Gernreich/swept-curve/README.md

# Trumpet, swept curve

**[← All projects](https://gernreich.github.io/)**

<!-- readme-only -->
**[Read the writeup](https://gernreich.github.io/swept-curve/)** ·
**[Turn the built spiral in 3D](https://gernreich.github.io/swept-curve/built/ribbon-spiral-bore10-45deg-R35to113/ribbon-spiral-bore10-45deg-R35to113.html)**

<!-- page-only **[Read the README](https://github.com/Gernreich/swept-curve)** · **[Turn the built spiral in 3D on a page of its own](built/ribbon-spiral-bore10-45deg-R35to113/ribbon-spiral-bore10-45deg-R35to113.html)** -->

<!-- page-only <iframe src="built/ribbon-spiral-bore10-45deg-R35to113/ribbon-spiral-bore10-45deg-R35to113-embed.html" title="The built spiral's airway, 1000 mm of 10 mm square bore winding out on a planar spiral, with the bell in its port and the mouthpiece on its tail, turning slowly until you drag it" style="width:100%;height:560px;border:0"></iframe> -->

A trumpet bore cut flat from 3 mm birch ply, swept along a curve rather than
walked through a grid of cubes. A **10 mm square** airway is drawn along a
planar curve, so two faces of the tube are flat — the two **cheeks**, each one
plate — and the other two are faceted, a wall panel standing in mortices at
every facet. Nothing about it sits on a grid and nothing in it is an elbow, so
none of these could be built in Minecraft. That is what separates them from the
grid-block trumpets in
**[trumpet-elbows-allowed](https://gernreich.github.io/trumpet-elbows-allowed/)**, the same instrument walked through cubes.

They are versions of that same trumpet, not a different instrument. The airway
is the same 10 mm square, and every design here takes the **same bell and the
same mouthpiece**, which live in trumpet-elbows-allowed:
**[the bell and the mouthpiece](https://gernreich.github.io/trumpet-elbows-allowed/ends/)**.

What a swept curve buys is a smooth turn. The section grows at every mitre, and
on a curve it grows far less than at a grid corner:

| | curve | section at a turn | why it exists |
| --- | --- | --- | --- |
| grid walk | 90° turns | +41.4% | fits a walk into a box |
| swept curve | any planar curve | +3.5% at 30°, +8.2% at 45° | constant section on a smooth curve |

The grid walk packs into a box; a swept curve lies flat and turns gently.

---

## Built

**[The spiral bore](ribbon-spiral/)** — 1000 mm in 19 facets of 45°, winding out
from R34.7 to R112.9. Both sheets cut, press-fit, a bell in its square port and a
mouthpiece on its straight tail, finished in shellac and blown; its note is not yet reported.
**[Turn it in 3D](built/ribbon-spiral-bore10-45deg-R35to113/ribbon-spiral-bore10-45deg-R35to113.html)**,
with the bell in its port and the mouthpiece on its tail.

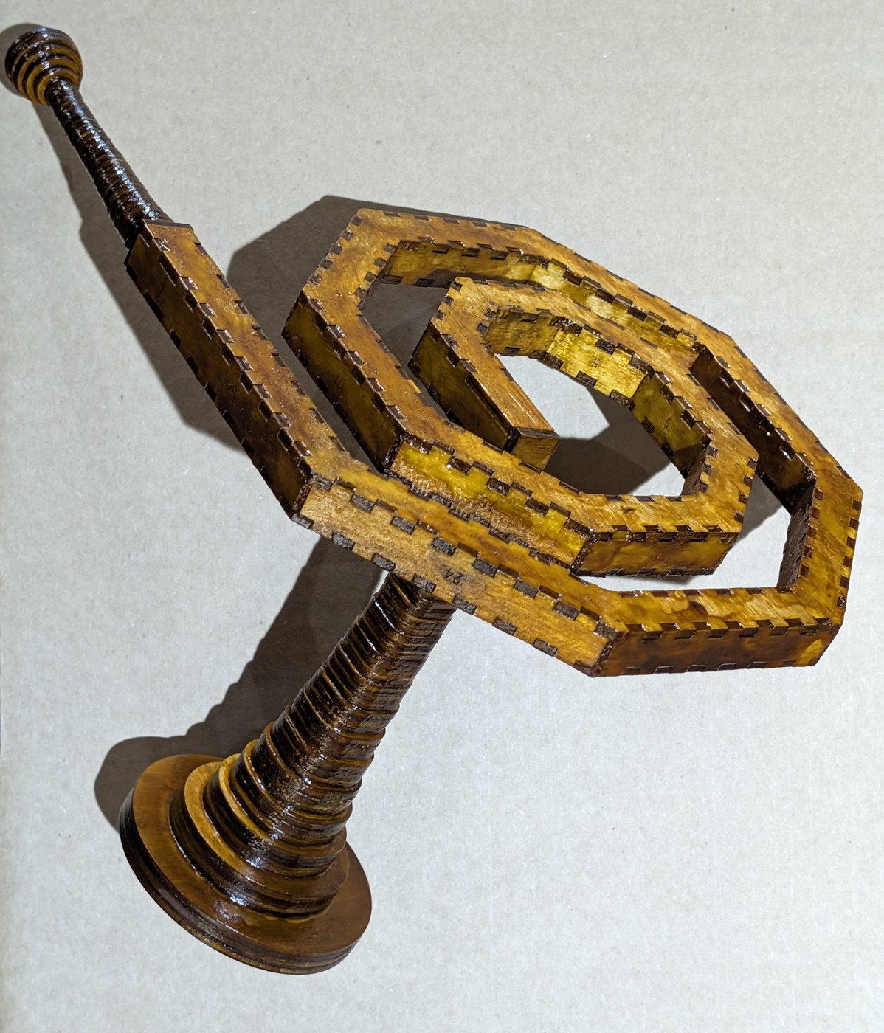
[picture p1: built/ribbon-spiral-bore10-45deg-R35to113/ribbon-spiral-bore10-45deg-R35to113-1000mm-ported-square-narrow-cheek-x2-finished_web.jpg]
The finished spiral standing upright on its bell on grey card: the bell's round rim flat on the card and its ribbed throat rising into the port at the inner end of the coil, the faceted band winding a little over two turns above it in glossy amber-brown with darker tabs along both rims, and the str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


## Designed, not yet cut

Each has its cut files and a viewer you can turn, drawn with the mouthpiece on
one end and the bell on the other, so each is a whole trumpet once those are
fitted.

| design | centreline | facets | what it is |
| --- | ---: | --- | --- |
| **[double spiral](double-spiral/ribbon-double-spiral-bore10-30deg-R62-pitch46-1506mm/ribbon-double-spiral-bore10-30deg-R62-pitch46-1506mm.html)** | 1506.4 mm | 30° | two interleaved arms winding in to meet at the centre, a straight lead leaving the rim at the top and another at the bottom |
| **[short double spiral](double-spiral/ribbon-double-spiral-bore10-30deg-R62-pitch46-1000mm/ribbon-double-spiral-bore10-30deg-R62-pitch46-1000mm.html)** | 1000.0 mm | 30° | the same with five facets off each arm, and the only design ported at both ends |
| **[double volute](volute/double-volute-bore10-45deg-R94-step60/ribbon-double-volute-bore10-45deg-R94-step60.html)** | 1179.9 mm | 45° | two interleaved arms of straight-sided semicircles winding in to meet at the eye |
| **[three-lobe serpentine](three-lobe-serpentine-with-collinear-ends/three-lobe-serpentine-with-collinear-ends-bore10-30deg-3lobes-R64/three-lobe-serpentine-with-collinear-ends-bore10-30deg-3lobes-R64.html)** | 1000.0 mm | 30° | three rounded lobes in a row, a straight lead at each end pointing opposite ways |
| **[serpentine](serpentine/ribbon-serpentine-bore10-30deg-3lobes-R72/ribbon-serpentine-bore10-30deg-3lobes-R72.html)** | 1000.0 mm | 30° | three lobes of R72 |
| **[ess](ess/ribbon-ess-bore10-45deg-5arc/ribbon-ess-bore10-45deg-5arc.html)** | 836.5 mm | 45° | a trough and a crest of R55, doubling back into a long narrow loop, level at both ends |

One more is drawn and not cut: the **[single volute](volute/single-volute/single-volute-bore10-45deg.html)**,
six semicircles of stepping radius from `volute/volute.rs`. Its inner end is
enclosed, with nowhere to go, and its two openings come out 135° apart, so it has
no cut files.

## Closed rings

A ring has no ends, so it cannot take a mouthpiece and a bell the way the
designs above do. These four are drawn because the mitring a ring needs is the
mitring every other shape needs. The ring and the scallop take two ports on named
facets, one through each cheek, which gives a mouthpiece and a bell two air paths
between them. None has been cut.

| design | centreline | facets | what it is |
| --- | ---: | --- | --- |
| **[ring](torus/ribbon-torus-bore10-27.6923deg-R128.572-800mm/ribbon-torus-bore10-27.6923deg-R128.572-800mm.html)** · **[square-ported](torus/ribbon-torus-bore10-27.6923deg-R128.572-800mm/ribbon-torus-bore10-27.6923deg-R128.572-800mm-ported-square.html)** | 800 mm | 13 of 27.7° | a 13-facet ring, ported on facets 0 and 6 |
| **[scallop](scallop/ribbon-scallop-bore10-36deg-5lobes-R44.2214-in41-800mm/ribbon-scallop-bore10-36deg-5lobes-R44.2214-in41-800mm.html)** | 800.0 mm | 36° | five lobes, ported on facets 1 and 14 |
| **[racetrack](racetrack/ribbon-racetrack-bore10-45deg-4lobes-R22-cap132.809-1600mm/ribbon-racetrack-bore10-45deg-4lobes-R22-cap132.809-1600mm.html)** | 1600.0 mm | 45° | four lobes and two caps; no port clears a neighbouring mortice, so it is unported |
| **[oval](oval/ribbon-oval-bore10-30deg-end60-R28-side-R72-flat12.2-sideflat12.5-314mm/ribbon-oval-bore10-30deg-end60-R28-side-R72-flat12.2-sideflat12.5-314mm.html)** | 314.4 mm | 30° | a small closed loop, unported |

## The double spiral

The **double spiral** is one of two shapes here whose two arms interleave — the
double volute is the other, the same skeleton drawn on semicircles. Two arms
half a turn apart about one centre, crossed in the middle by a straight:
1506.4 mm of bore on a cheek plate 232 × 241 mm. Arm B *is* arm A turned through
180°, so the gap between neighbouring passes is half the radial pitch by
construction rather than by search — choose the pitch and you have chosen the
gap. The cheek is a 20 mm band, so 46 mm a turn is the first pitch that clears it,
and the two passes come out 23.00 mm apart.

Its centreline is the one that does not step its arc radius facet by facet.
Vertices sit on a smooth spiral `r = R0 + b·θ` sampled every facet instead, which
the note beside `--shape=spiral` warns is the construction `offset()` cannot
follow. That note is about offsetting a smooth curve and faceting the result
separately; offsetting the faceted centreline is exact whatever placed its
vertices, and the airway measures 4.4e-14mm from the bore here. The stepping
construction could not be used anyway — its polar radius advances 7 mm across one
half turn and 32 mm across another, and two arms interleaved at those radii
collide.

The open middle is forced, not styled. A straight through the centre is tangent
to the crossover arc only when the arm's inner end lies outside **twice** that
arc's radius, so R62 against R30 is a floor; tighten it and the inner panels stop
being long enough to hold a 6 mm tooth, and the generator refuses rather than
drawing one. Both openings still come out on the rim facing opposite ways, which
is what a total turning of 0° buys.

Two arms wound into each other is the arrangement here that could have run
the bore back into itself, and the check that would have caught it already
existed: *the cheek outline does not cross itself*. It passes, at 85 edges and no
crossings.

The **short double spiral** is that same spiral with five facets taken off each
arm, 14 down to 9 — a trim and not a redraw: the pitch, the R62 start and the
R30 crossover are the shipped design's, and the shape stays point-symmetric
because a facet comes off each end at once. 1000.0 mm on a 186 × 236 mm cheek,
against 1506.4 mm on 232 × 241 mm.

The **facet** is what quantises it and the **lead** is what lands it. Nine
facets an arm give 956.0 mm and ten give 1058.2, so the trim alone cannot reach
1000 —
whole facets are the only thing that comes off, and they come off about 100 mm
at a time. The last 44 mm is bought by lengthening both leads from 20 mm to 42:
the lead is a straight run tangent to the arm, so it adds length without moving
a single facet of the coil. That it costs 42 mm of straight tail at each rim is
the price, and the reason the figure is quoted as a choice and not as what the
generator happened to give.

It is also the only open design in this repository **ported at both ends** —
the ported rings take their two ports on named facets, having no ends. One
square port is bought by folding the mouth lead into the facet it already lies
on, and the far end wants the same thing: `--port-both` folds the tail lead
too, or the second port lands on that lead's single tooth and the generator
refuses — the refusal being correct, and the reason the flag does the fold
rather than overruling the check. Two ports mean two open ends, so `--cap`
draws two caps. The mortices do not move: against the unmerged build, four
lead panels drop and not one surviving tooth shifts.

It ships **two port arrangements**, and the difference is which joints have been
made before. The one-port set is the spiral's: the port takes the bell, its stub
is capped, and the far rim end stays open so the mouthpiece seats on the tube
end, where four walls grip the full 16 mm. That is the arrangement standing in
ply on **[the spiral bore's page](ribbon-spiral/)**, where the photograph shows
the bell on its throat in the port and the mouthpiece out on the tail.

The two-port set below is the one where the mouthpiece must seat in a port —
10 × 10 mm through a single 3 mm cheek — which a bell has done and a mouthpiece
has not. A bell sits where it is put; a
mouthpiece takes lip pressure.

In the two-port set the ports are **split between the two cheeks**, which is
what makes it an instrument rather than a coil with holes in it. A port through
both cheeks is a socket right through, and the side you are not using is an
open hole to plug; two of those are waste. `--port-per-cheek` puts one port on
each sheet instead — `cheek-a` carries the mouth, `cheek-b` the far end, each
cut once — so the mouthpiece **enters one face and the bell leaves the other**,
at points 222.5 mm apart and exactly opposite through the coil's centre. The
openings are no longer in the plane at all, so the total-turning-zero argument
that sets the two rim ends on opposite headings has stopped describing how it
is played: those ends are the capped ones. `rotatable()` reports that the two
sheets are the same part half a turn apart, to 9e-16mm — so one sheet cut twice
with one turned round would also do, at the price of engraved numbers upside
down on the turned one.

## The generator

`ribbon_bore.rs` draws every sheet here, and `ribbon_view.rs` every viewer page;
the viewer reads its design from the generator rather than keeping a copy. Both
are Rust since 2026-11-07, built with `cargo build --release` (`Cargo.toml` and
`Cargo.lock` beside them); they were Python until then, and the move changed no
byte of any sheet or page. `CLAUDE.md` holds the rules for changing either, and
`NOTES.md` the reasoning and measurements behind them.

```sh
cargo build --release
target/release/ribbon_bore --shape=spiral --port --port-square --cap --narrow --no-write
```

That runs every check on the built spiral's design and writes nothing. Every
shipped sheet is `--narrow`; **[the spiral bore's page](ribbon-spiral/)** gives
the command that drew the sheets that were cut. `ribbon_bore.rs` is also a
library: it lends its path writer to [square-flute](https://github.com/Gernreich/square-flute),
the ocarinas, the panpipes and the chanters, and its panels and sheets to
[lyre-harp](https://github.com/Gernreich/lyre-harp), each of which expects this
repository cloned beside it.

## SolidCraft designs

Every design folder also holds the bore as a parametric SolidCraft design,
`solidcraft/NAME.sc` beside the script it was built from
(`solidcraft/NAME.solidcraft.json`), and the STEP file SolidCraft builds from it,
`step/NAME.step`, to open or import in a CAD program such as Fusion or FreeCAD: one
solid body per part, in millimetres, assembled, with no parameters. The bore lies flat
as the cut files draw it, the cheeks above and below.

The centreline's vertices are the design's parameters (`c0_x`, `c0_y` and on, under the
**SOLID** tab, **MODIFY** panel, **Change Parameters**), with these:

| Parameter | Default | What it is |
| --- | --- | --- |
| `bore` | 10 mm | the airway, wall face to wall face and cheek to cheek |
| `ply` | 3 mm | the walls and cheeks, nominal |
| `sheet` · `kerf` · `slot_tighten` | 3 · 0.15 · 0 mm | what the sheet calipers, the beam, and how much narrower the mortices are drawn: together, how far each narrow cheek runs past its walls |
| `tooth` · `shoulder` · `play` | 6 · 2 · 0.025 mm | each tooth and each gap along a panel, the least of it left past its end teeth, and each mortice's play a side along its tooth |
| `port_across` · `port_along` · `port_from_tip` | as built | a ported design's ports, as cut, and each one's middle along its facet |

Everything else is a read-only parameter worked out from these as `ribbon_bore.rs`
works it out: each wall offset (bore + ply)/2 from the centreline and mitred where its
neighbouring offset lines meet, the cheeks' rims the same way, each panel along its
wall with its ends trimmed ply/2 · tan(turn/2). So moving a vertex moves the walls,
cheeks and panels with it. The panels have their teeth and the cheeks their mortices
(2026-11-09), each panel as many teeth as its length holds; a panel whose cut
files carry another count keeps it (twelve panels, all in the four ported designs). The cheeks' rims are as cut: the generator draws
a narrow cheek's rim on its mortices' outer edges with no kerf added, so the beam
leaves it half a kerf inside the line, at a free end too, and every mortice is a notch
open to the rim. Each design has the ports its committed cheeks are cut with (the
spiral, the 1506 mm double spiral, the scallop and the torus, square-ported); none
has caps. The built spiral's lead panel is folded into the next, as its cut files fold
it.

**Checked**: before writing, `ribbon_solidcraft.rs` checks every wall point, rim point
and panel against the generator's own, and the script stops if one is off. Built by
SolidCraft, no two parts of any design overlap. The serpentine and the ring changed to
a 12 mm bore match the generator's `--bore=12` part by part, and the serpentine with a
vertex moved 4 mm still builds with no overlap. Read back with `sc-flatten
--redraw-all`, every one of the eleven designs lands on its committed cut files: cuts
within 0.021 mm, engraved marks within 0.113 mm (2026-11-09).

```sh
target/release/ribbon_view --shape=serpentine --narrow --solidcraft=FILE.solidcraft.json
solidcraft-cli run FILE.solidcraft.json --save NAME.sc     # or --out NAME.step
```

The flags are the design's own, as its viewer page is drawn, plus `--narrow`.

## Files

| | |
| --- | --- |
| `built/` | the spiral bore, which exists in wood: its cut files, previews, photographs, viewer, and the framed build of the viewer this page opens with |
| `ribbon-spiral/` | the spiral bore's page |
| `double-spiral/` · `volute/` · `three-lobe-serpentine-with-collinear-ends/` · `serpentine/` · `ess/` | the open designs, a folder each: cut files, a viewer and the SolidCraft design with its STEP file |
| `torus/` · `scallop/` · `racetrack/` · `oval/` | the closed rings, the same way |
| `previews/` | display renderings of the designs' cut files — **not** cut files |
| `ribbon_bore.rs` · `ribbon_view.rs` · `ribbon_view_page.rs` · `bin/` | the generator and the viewer (the last holds the viewer's page, browser code); `Cargo.toml` · `Cargo.lock` build them |
| `ribbon_solidcraft.rs` | each design as a parametric SolidCraft design, written by `ribbon_view --solidcraft=FILE` into the design's `solidcraft/` and built into its `step/` |
| `volute/volute.rs` · `volute/volute.json` | the compass construction behind the single volute |
| `CLAUDE.md` · `NOTES.md` | the rules, and the reasoning behind them |
| `README.md` · `index.html` | this writeup and its published page; the markdown is the source |

Until 2026-10-14 all of this was `parts/bore/concept/swept-curve/` and part of
`built/` in trumpet-elbows-allowed, and its history came with it.

## More, and licence

Built for **[LaserMadeMusic](https://www.youtube.com/@LaserMadeMusic)**, where the
cutting and the playing are shown.

**[The rest of the build files](https://gernreich.github.io/lasermademusic.html)** — every instrument,
each with its own writeup.

**[Download everything as a ZIP](https://github.com/Gernreich/swept-curve/archive/refs/heads/main.zip)**

Released under [CC0 1.0](LICENSE). Boxes.py is Florian Festi's and is
GPL-3.0-or-later; none of it is in this repository.

## Credits

Made by Michael Gernreich with [Claude](https://www.anthropic.com/claude) (Anthropic), working in Claude Code, which co-wrote the code and the documentation. Commits Claude made carry a `Co-Authored-By: Claude` line.
