Gernreich/swept-curve/built/ribbon-spiral-bore10-45deg-R35to113/ribbon-spiral-bore10-45deg-R35to113-1000mm-ported-square-narrow-cheek-x2-glued-up_web.jpg

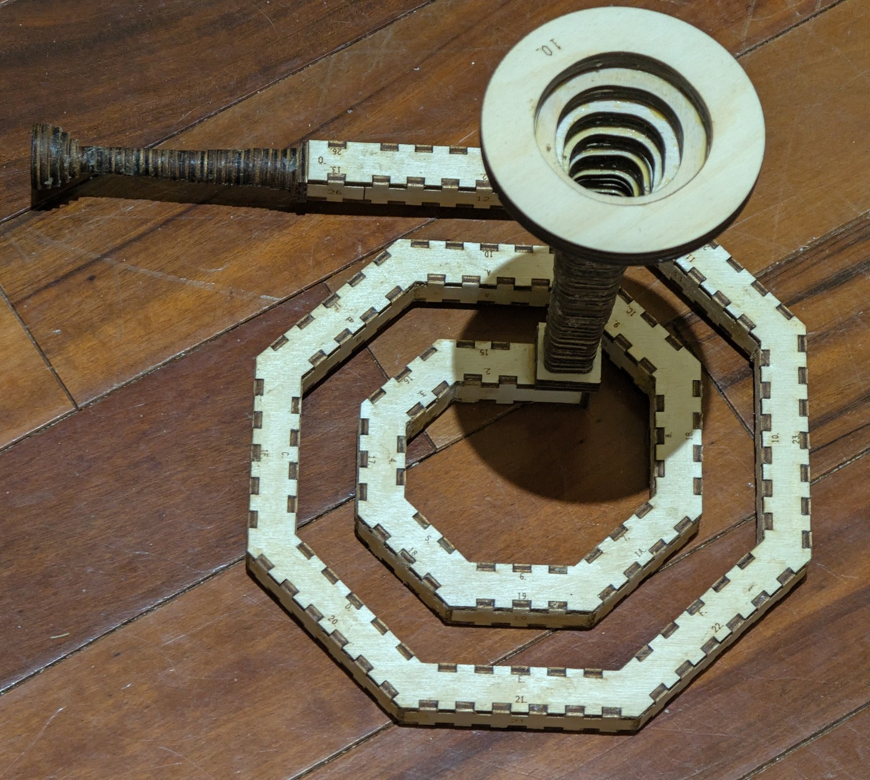
built/ribbon-spiral-bore10-45deg-R35to113/ribbon-spiral-bore10-45deg-R35to113-1000mm-ported-square-narrow-cheek-x2-glued-up_web.jpg
