Gernreich/swept-curve/built/ribbon-spiral-bore10-45deg-R35to113/step/ribbon-spiral-bore10-45deg-R35to113.step

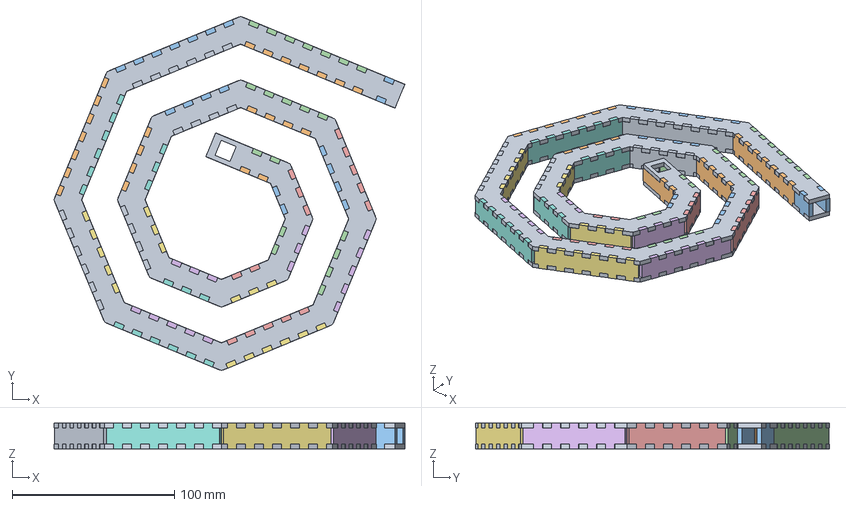
[picture p4: CAD file, 2026-11-09]
built/ribbon-spiral-bore10-45deg-R35to113/step/ribbon-spiral-bore10-45deg-R35to113.step
216.5 x 218.3 x 16.0 mm
