Gernreich/swept-curve/double-spiral/ribbon-double-spiral-bore10-30deg-R62-pitch46-1000mm/step/ribbon-double-spiral-bore10-30deg-R62-pitch46-1000mm.step

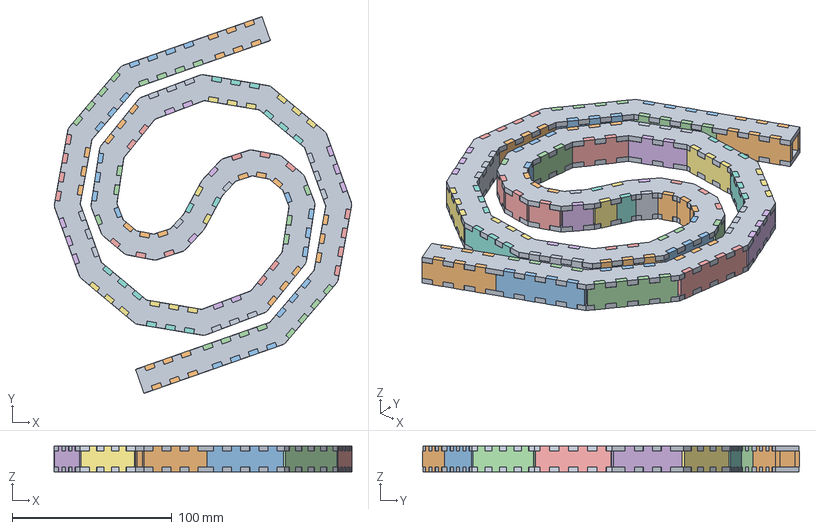
[picture p5: CAD file, 2026-11-09]
double-spiral/ribbon-double-spiral-bore10-30deg-R62-pitch46-1000mm/step/ribbon-double-spiral-bore10-30deg-R62-pitch46-1000mm.step
186.2 x 235.9 x 16.0 mm
