Gernreich/swept-curve/double-spiral/ribbon-double-spiral-bore10-30deg-R62-pitch46-1506mm/step/ribbon-double-spiral-bore10-30deg-R62-pitch46-1506mm.step

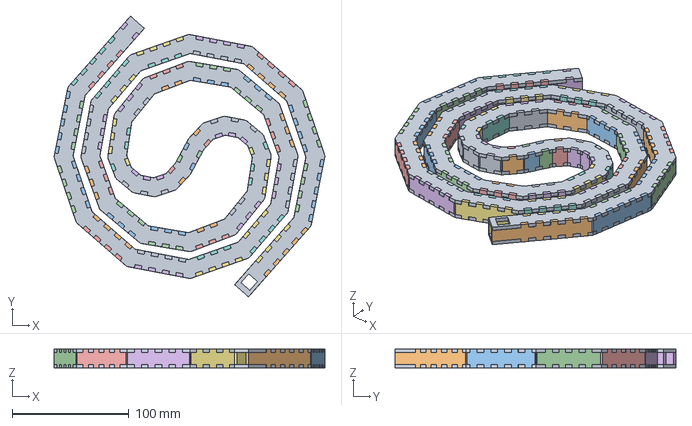
[picture p6: CAD file, 2026-11-09]
double-spiral/ribbon-double-spiral-bore10-30deg-R62-pitch46-1506mm/step/ribbon-double-spiral-bore10-30deg-R62-pitch46-1506mm.step
232.2 x 240.9 x 16.0 mm
