Gernreich/swept-curve/ess/ribbon-ess-bore10-45deg-5arc/step/ribbon-ess-bore10-45deg-5arc.step

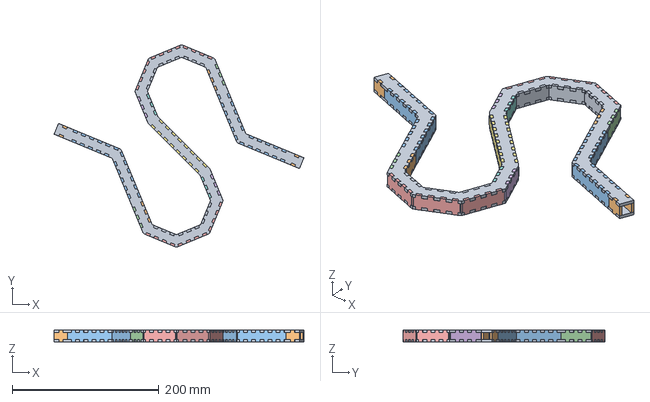
[picture p7: CAD file, 2026-11-09]
ess/ribbon-ess-bore10-45deg-5arc/step/ribbon-ess-bore10-45deg-5arc.step
340.1 x 275.5 x 16.0 mm
