Gernreich/swept-curve/oval/ribbon-oval-bore10-30deg-end60-R28-side-R72-flat12.2-sideflat12.5-314mm/step/ribbon-oval-bore10-30deg-end60-R28-side-R72-flat12.2-sideflat12.5-314mm.step

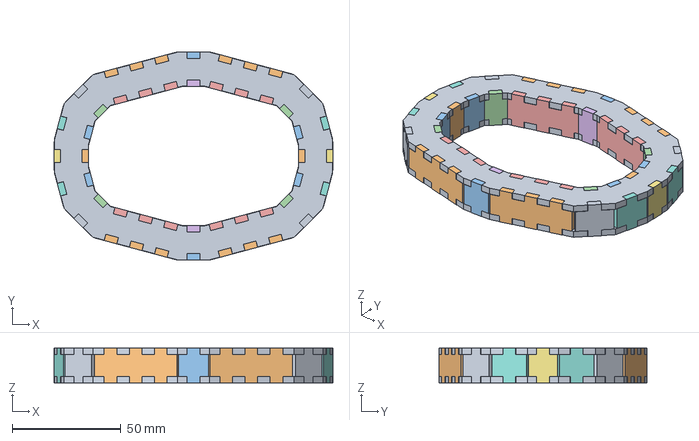
[picture p8: CAD file, 2026-11-09]
oval/ribbon-oval-bore10-30deg-end60-R28-side-R72-flat12.2-sideflat12.5-314mm/step/ribbon-oval-bore10-30deg-end60-R28-side-R72-flat12.2-sideflat12.5-314mm.step
128.5 x 96.0 x 16.0 mm
