Gernreich/swept-curve/racetrack/ribbon-racetrack-bore10-45deg-4lobes-R22-cap132.809-1600mm/step/ribbon-racetrack-bore10-45deg-4lobes-R22-cap132.809-1600mm.step

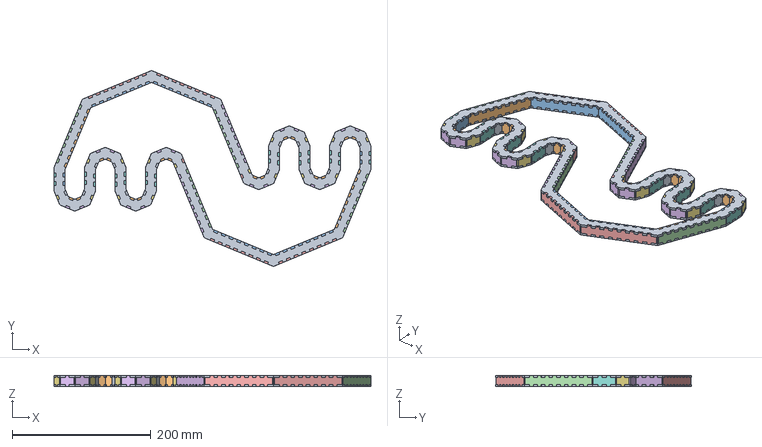
[picture p9: CAD file, 2026-11-09]
racetrack/ribbon-racetrack-bore10-45deg-4lobes-R22-cap132.809-1600mm/step/ribbon-racetrack-bore10-45deg-4lobes-R22-cap132.809-1600mm.step
457.6 x 282.6 x 16.0 mm
