Gernreich/swept-curve/scallop/ribbon-scallop-bore10-36deg-5lobes-R44.2214-in41-800mm/step/ribbon-scallop-bore10-36deg-5lobes-R44.2214-in41-800mm.step

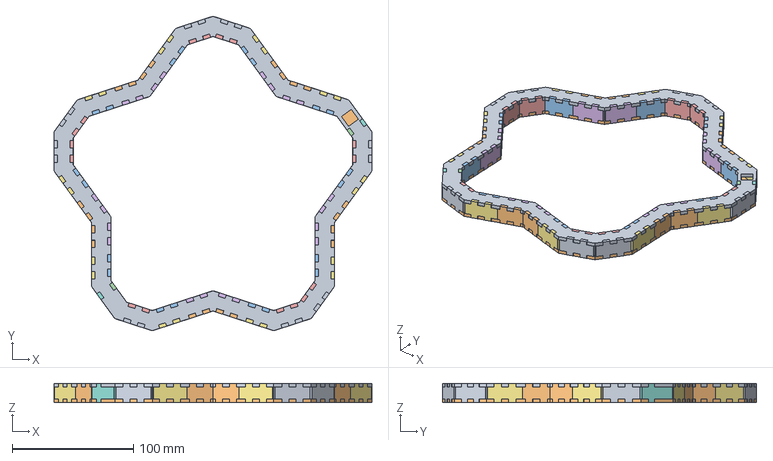
[picture p10: CAD file, 2026-11-09]
scallop/ribbon-scallop-bore10-36deg-5lobes-R44.2214-in41-800mm/step/ribbon-scallop-bore10-36deg-5lobes-R44.2214-in41-800mm.step
262.2 x 259.1 x 16.0 mm
