Gernreich/swept-curve/serpentine/ribbon-serpentine-bore10-30deg-3lobes-R72/step/ribbon-serpentine-bore10-30deg-3lobes-R72.step

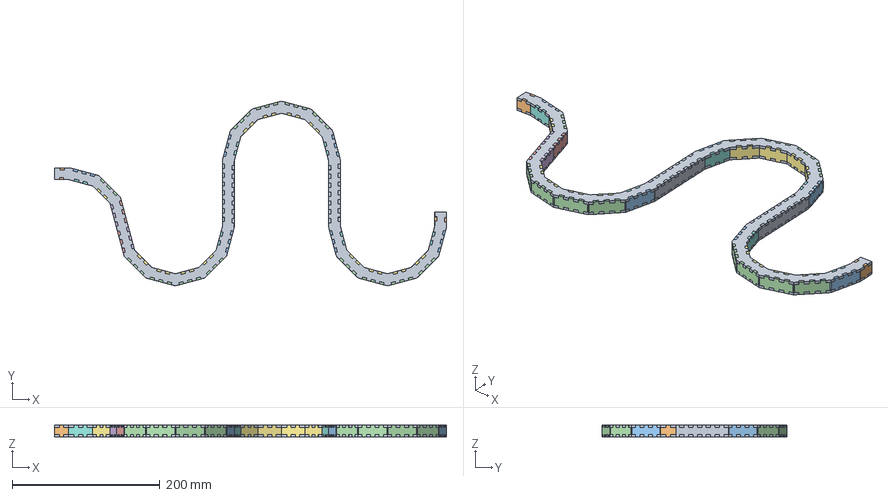
[picture p11: CAD file, 2026-11-09]
serpentine/ribbon-serpentine-bore10-30deg-3lobes-R72/step/ribbon-serpentine-bore10-30deg-3lobes-R72.step
530.3 x 249.8 x 16.0 mm
