Gernreich/swept-curve/three-lobe-serpentine-with-collinear-ends/three-lobe-serpentine-with-collinear-ends-bore10-30deg-3lobes-R64/step/three-lobe-serpentine-with-collinear-ends-bore10-30deg-3lobes-R64.step

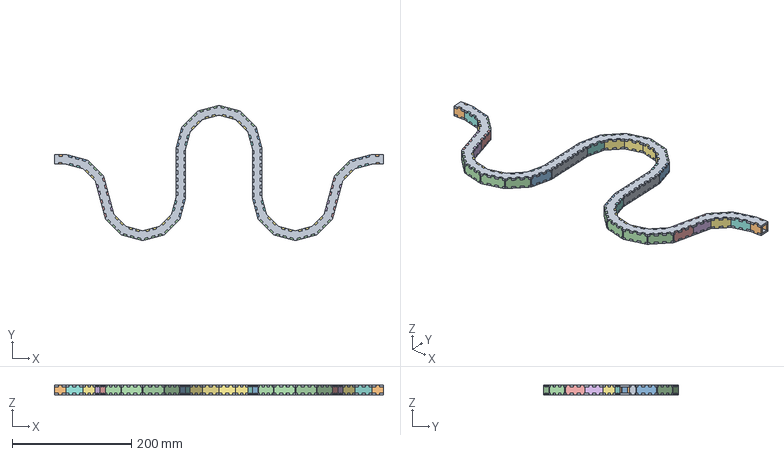
[picture p12: CAD file, 2026-11-09]
three-lobe-serpentine-with-collinear-ends/three-lobe-serpentine-with-collinear-ends-bore10-30deg-3lobes-R64/step/three-lobe-serpentine-with-collinear-ends-bore10-30deg-3lobes-R64.step
552.0 x 226.7 x 16.0 mm
