Gernreich/swept-curve/torus/ribbon-torus-bore10-27.6923deg-R128.572-800mm/step/ribbon-torus-bore10-27.6923deg-R128.572-800mm.step

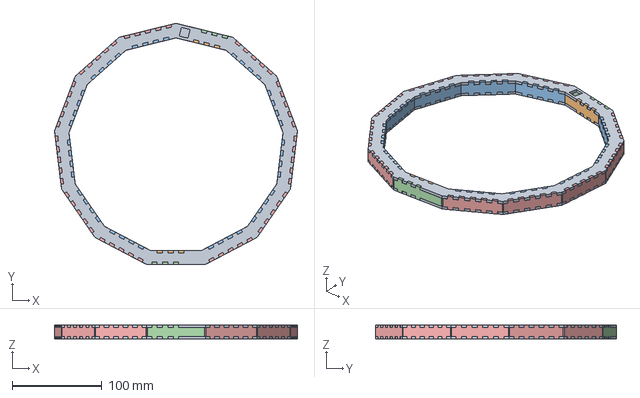
[picture p13: CAD file, 2026-11-09]
torus/ribbon-torus-bore10-27.6923deg-R128.572-800mm/step/ribbon-torus-bore10-27.6923deg-R128.572-800mm.step
271.4 x 269.5 x 16.0 mm
