Gernreich/swept-curve/volute/double-volute-bore10-45deg-R94-step60/step/double-volute-bore10-45deg-R94-step60.step

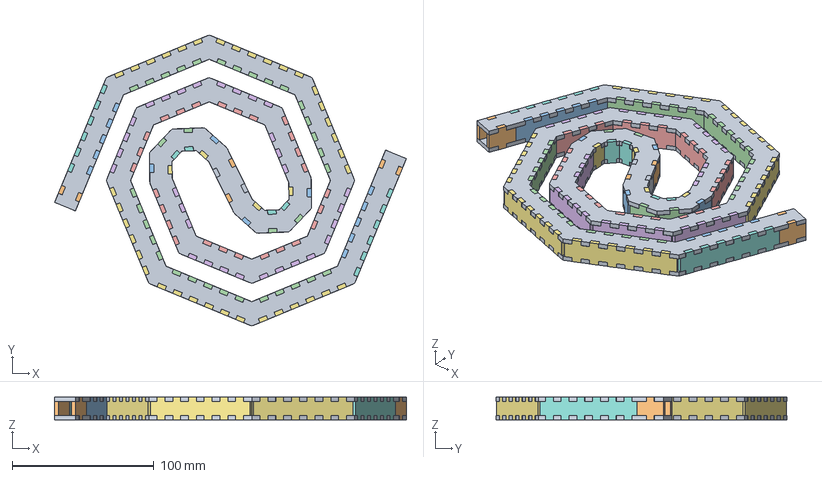
[picture p14: CAD file, 2026-11-09]
volute/double-volute-bore10-45deg-R94-step60/step/double-volute-bore10-45deg-R94-step60.step
248.1 x 205.0 x 16.0 mm
