Gernreich/swept-curve/(commit log)

2026-09-06 Restructure: a trumpet is a mouthpiece, a bore and a bell
    The top level was five siblings that did not say how they related --
    bores/, designs/, spirals/, parts/, tools/ -- with parts/ meaning only
    the two ends and the tube filed somewhere else entirely. It now says the
    thing the project has been repeating since the first writeup: a trumpet
    is a mouthpiece, a length of tube and a bell, and only the tube differs.
    parts/mouthpiece/
    parts/bell/
    parts/bore/built/ exists in plywood
    parts/bore/concept/ exists as a walk and a cut file
    walk/elbows/ a turn stranded as its own piece
    walk/no-elbows/ every turn folded into a piece
    s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
2026-09-06 Give every swept-curve bore its own directory, cut files apart
    swept-curve held one flat ribbon/ folder of 28 cut files, 10 pages and two
    generators, with the bore a file belonged to legible only from its name.
    It is now a directory per curve type, a directory per bore inside that,
    and the four cut files of each bore in a cut-files/ of their own:
    swept-curve/
    coupon/ opposed/ serpentine/ wave/
    spiral/
    ribbon-spiral-bore10-45deg-R35to113/
    ribbon-spiral-bore10-45deg-R36to144/
    ribbon-spiral-bore10-45deg-R74to144/
    cut-files/
    Seven bores, four cut files each. ribbon/ itself is gone: the generators,
    the writeup and traces/ and volute/ sit at swep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
2026-09-06 10mm is the only bore: no 25/31mm left in code or prose
    The octagonal work leaves the repository. ribbon-torus-bore25-45deg-R76.html,
    ribbon-traced-octagonal-trumpet-bore25-45deg.html and traces/octagonal-trumpet.json
    move to ~/LaserMadeMusic/octagonal, which is deliberately not a git repository.
    --shape=torus and --trace= stay: they are general, and the next closed ring or
    measured curve will want them. traces/ keeps volute.json.
    Defaults follow. bell.py and mouthpiece.py - the square pair, which ship no cut
    files - go to BORE 10.0, PLATE 16.0, RT 5.0. sizes.py holds one row.
    PLAY_BY_BORE is {10.0: 0.025} in both bore_split.py and ribbon_bore.py, and the
    clearance note stands on the 10mm b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
2026-09-06 Second 25/31mm pass: the ones that were live code, not prose
    The first pass swept what said "25mm" or "31mm". This one swept every bare 25
    and 31, which is where the arithmetic was hiding.
    Live code that was still cutting or printing at the old pitch:
    - mouthpiece.py was BROKEN, by my own previous commit. PLATE moved to 16 while
    cup[0] stayed at a 25mm aperture, so station one's hole was wider than its own
    plate and the seat check refused to write: "station 2 falls through station 1".
    The cup is now derived - BORE down to a 5mm neck over NCUP stations - so it
    cannot be left behind by a change to BORE again. Runs, 23 rings, 10 -> 3.66 ->
    10.06mm.
    - hilbert.py multiplied block coun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
2026-09-07 Generated sheets go in cut-files/; the command block runs
    Every reader in parts/ looks in cut-files/, and the generators wrote beside
    themselves. Running the command block in parts/CLAUDE.md therefore dropped 22
    loose sheets into parts/bell and parts/mouthpiece that nothing read and the next
    `git add` would have committed. Five generators now place a GENERATED name via
    in_cut_files(); a name the caller gives is still used exactly as given, wherever
    it points.
    The readers move the other way. A section, view or turn drawing is not a cut
    file -- send one to a laser and it is scrap -- so display_out() climbs back out
    of cut-files/ to the part's own directory, dropping the "-cut-files" the sourc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
2026-09-07 Lenses 9-13 across the eight CLAUDE.md files
    The cross-document lenses, which compare documents with each other and with the
    repository rather than reading one in isolation. Everything below was tested, not
    inspected.
    LENS 9 -- THE SAME FACT STATED TWICE. Four stale check counts, each contradicted
    by a live run:
    fold2 "213 checks, 0 failed on this bore" -> 195
    fold2 "194 checks still say pass" -> 195
    flat-drop "253 checks on this design" -> 251
    fold2-long-str "still passes 392 checks" -> 393 on the 3t
    tools "reports 194 checks and 0 failed" -> 195
    Three of the five are off by exactly one, which is th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
2026-09-07 Add --shape=dspiral: two spiral arms interleaved about one centre
    1506.4mm of 10 x 10mm bore on a 237 x 244mm cheek plate, 42 facets of 30
    degrees, 84 wall panels and two cheeks across two sheets. Plain and ported,
    as every other design in this folder ships.
    Arm B IS arm A turned through 180 degrees, so the gap between neighbouring
    passes is half the radial pitch by construction rather than by search. The
    cheek is a 20mm band, so 46mm a turn is the first pitch that clears it and
    the passes come out 23.00mm apart.
    Its vertices sit on a smooth Archimedean spiral sampled every facet rather
    than on stepping-radius arcs. The note beside --shape=spiral calls that the
    one construction offset() ca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
2026-09-07 Give the wave and the spirals their own facet angle
    FACET defaults to the coupon's 30 and both are 45 degree designs, so a bare
    --shape=wave built arcs that do not close and reported six check failures,
    not one of which said "facet", and a bare --shape=spiral refused because 17
    facets turn 480 degrees at 30. Neither was a wrong number; the default was
    simply the wrong shape's.
    FACET_BY_SHAPE carries the angle a shape is drawn at, applied only where the
    caller has not passed --facet -- the same guard the opposed lobe already
    uses. dspiral's own default crossover radius moves 28 -> 30 for the same
    reason: it was cut at 30, and a bare run refused on a 9.77mm inner panel.
    All six shapes now bu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
2026-09-08 A centre-first test piece off the dspiral, and a repair to get it written
    --ds-half stops at the centre instead of carrying on into the second arm, and
    runs out from there, so the mouth is the middle of the coil. The crossover is
    the part of this shape that had to be solved rather than chosen, which makes
    it the part a coupon should prove. At --ds-facets=2 that is 195.8mm in 22
    parts on a 111 x 139mm cheek, cut plain and ported.
    The repair came first because nothing could be written without it. Every
    filename literal in the generator had "ribbon/" spliced into it - "-cut-files"
    had become "-ribbon/cut-files", "mm.svg" had become "ribbon/mm.svg", "-ported"
    had become "-ribbon/ported", and th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
2026-09-09 Finish dressing the double spiral: the four previews and the half's own page
    The 1506mm dspiral shipped without previews -- 36 cut files in swept-curve and
    32 previews, and the four missing were exactly its sheets, plain and ported. It
    was the only bore in the family without them.
    The half-196mm test piece had cut-files/ and nothing else, where every other
    bore directory, the coupon included, holds the page you turn beside the sheets
    you cut.
    Building that page needed two fixes in ribbon_view.py, both the same shape as
    faults already recorded in it. --ds-half was not in its argument table, so it
    was rejected outright -- the third thing this second copy of the generator's
    CLI has lacked tha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
2026-09-09 Sweep the volute: interleave the return arm, and both its problems go
    volute.py recorded two things it could not do and said what the work was:
    "interleaving a return arm so that both ends reach the rim". This is that.
    1. The inner end was enclosed. A volute winds in and STOPS, and that end came
    within 7.75mm of the rest of the bore where it needs 20. There is now no
    inner end: the arm runs rim to eye and the return arm carries it back out.
    2. The ends were not opposed. 24 facets at 45 degrees turn 1035 degrees, and
    opposed needs (F-1) a whole number of turns, i.e. F = 8k+1, which no whole
    number of semicircles gives. It cost nothing in the end. The arm's centres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
2026-09-09 Say which curve each shape's vertices sit on: the double spiral is Archimedean, the volute is a chain of semicircles
    The distinction existed only in one source comment. It appeared in no printed
    report, no page, and no writeup -- "Archimedean" occurred exactly once in the
    whole tree, beside DS_PITCH, and a reader of the drawings had nothing to go on.
    The two shapes look alike and are not.
    dspiral vertices sampled every facet off a smooth Archimedean spiral,
    r = R0 + b*theta, so the radius differs at every vertex
    volute a chain of semicircles of stepping radius about two alternating
    centres, the radius holding all the way across each arc
    It shows in the loca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
2026-09-09 Trim the wall panels so their corners stop jamming at every mitre
    Reported from the bench: the dspiral halftest was cut, and where the walls meet
    at less than 180 degrees the panel corners butted before anything could seat.
    It is real, it is in every ribbon bore shipped, and it is arithmetic.
    A panel end is a SQUARE cut -- a laser goes through the sheet and cannot mitre
    one -- and the offset polyline is the wall's CENTRELINE, so two neighbours have
    THICK/2 of ply either side of the point where their centrelines meet. On the
    concave side each runs past that point by (THICK/2)tan(phi/2), and the two
    corners collide. The overlap is THICK*tan(phi/2):
    30 degree facets, 3mm ply 0.804mm a j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
2026-09-09 Audit every check against geometry it should reject; three could not fail
    The halftest was cut with eleven checks passing and its corners jammed, so each
    check was given something it ought to fail. Seven do. Three cannot, and one of
    those was the headline.
    CANNOT FAIL
    the airway is the bore along every facet
    compares two offsets of ONE polyline, which are parallel to each facet at
    a fixed separation by construction. It returns 10mm for a straight line,
    for a hairpin tighter than its own wall, and for a zigzag reversing at
    every vertex. Kept -- it is the arithmetic of the section and would catch
    a mistake in offset() -- but it is not evidence.
    the shortest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
2026-09-09 Audit volute.py and ribbon_view.py; catch the generator's refusal in the viewer
    The last two check surfaces in this directory.
    volute.py. Two of its four checks are failing on the shipped design right now --
    the bore stays clear of itself at 7.75mm against the 20mm band, and the two
    openings are opposed at 135 degrees. That is the file's whole point, and it
    makes them the best-evidenced checks in the repository: no mutation needed. the
    cheek fits the P2S bed fires from --r0=200 up. Both its refusals hold, an arc
    under the tooth floor and a facet that does not divide a semicircle. The two
    failing checks are one condition stated twice and they agree: the run turns 1035
    degrees, 315 past whole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
2026-09-09 Take 0.1mm off the slots in both directions: the halftest assembled loose
    Reported from the bench after putting the dspiral halftest together. Taken off
    the SLOT and not added to the tab, which is this file's standing rule -- TOOTH
    feeds the shoulder arithmetic and the panel-length guard, so widening the tab
    moves numbers that are checked, while the notch is free.
    It has to come off the slot across the ply whatever the rule said, because in
    that direction the tab is not drawn at all: its thickness IS the sheet, and
    nothing in an SVG can add to it.
    slot drawn slot cut fit
    along the tooth 5.950 -> 5.850 6.050 -> 5.950 +0.050 -> -0.050mm
    across the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
2026-09-09 The ply is 2.94mm and the kerf 0.13mm: put the measured numbers in
    Calipered at the bench. Both constants were assumptions, and both were wrong in
    the direction that makes a joint loose -- parts come out smaller than drawn and
    holes bigger, and the sheet was 0.06mm thinner than the slot cut for it.
    along the tooth across the ply
    as you cut it +0.110mm +0.090mm
    now +0.050mm +0.000mm
    The first row is the joint that was loose: twice the slack this file asks for in
    one direction and, in the other, 0.09mm of slack where it specifies none. The
    second row is what it always meant to cut. So yesterday's 0.1mm slot tig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
2026-09-09 The sheet and the kerf are variables now, and the block bores get the real ones
    Answering the question directly: no, the ply thickness was NOT a variable. It
    was a module constant in two files, reachable only by editing them, and so was
    the kerf. Both are flags now, --sheet= and --burn=, on both generators.
    bore_split.py gets the same two-number split ribbon_bore.py got. THICKNESS stays
    3.0 and is a DRAWN dimension -- the airway is BLOCK - 2*THICKNESS, so putting
    2.94 there would make this a 10.12mm bore and rename every cut file from bore10-
    to bore10.12-. SHEET is 2.94 and goes where the material belongs: Boxes.py is
    handed it as --thickness, because Boxes cuts the finger slots and a slot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
2026-09-09 Boxes.py's --burn is the RADIUS: my 0.13 told it the kerf was 0.26
    Caught on a second pass, and it was mine, made this morning. Boxes.py sets its
    line width to 2*burn and offsets each side of a line by burn, so burn is half
    the kerf. Measured rather than read: raising --burn by 0.17 widened every drawn
    outline by 0.34.
    bore_split spends its own BURN as 2*BURN everywhere -- in the span arithmetic
    and the bed arithmetic -- which only balances on the same radius convention. So
    its old 0.1 always meant a 0.2mm kerf, and setting it to the measured 0.13 this
    morning told Boxes 0.26mm and compensated every part by twice what the laser
    removes.
    KERF = 0.13 measured, the full width of the cut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
2026-09-10 The port breaks into its neighbouring slot on every ported cheek
    Eighth pass, running flat-part-check over the ribbon sheets now that it can
    read them -- a gate that had never been applied to these files. It reported
    0.03mm of material where it wants 3mm, on the ported cheeks and only those.
    Measured directly rather than trusted: the port is 0.029mm from slot 0 on all
    TEN ported cheeks in the project. The kerf is 0.13mm and takes half from each
    edge, so the two holes are one hole. Every ported cheek that has been drawn
    here is uncuttable, and has been since the port was added.
    TWO FAULTS, ONE FIXED.
    port_hole() drew the hole OVER size. Its own comment said "the hole is a hole:
    kerf goes u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
2026-09-10 The longer lead does clear the port, and this file already said it cannot
    I offered lengthening the lead as the way to keep a bore-wide port, and it was
    the wrong option to offer: the label-sliding code in this same file has said so
    since before I touched it --
    "the alternative, giving the port a bore of extra lead, moves the whole coil
    and was what made the cheek cross itself"
    -- and I had not read that far before putting the choice up. Built anyway, and
    it reproduces exactly that. PORT_LEAD = 30 clears the port beautifully on the
    coupon, 0.030mm of ply becoming 2.931mm and every check passing, and then:
    spiral the cheek outline starts crossing itself
    volute 39 slot corners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
2026-09-10 A check count moved and a document did not; and my own audit was too kind
    Ninth pass, on the lens pass 8 proved out: not re-reading the scripts, but
    pointing tools at artefacts they have never seen, and reading what the files
    already record.
    THE BLOCK SHEETS THROUGH THE FLAT GATE, never done before. Boxes' own output
    comes back 8 of 9, failing only "holes are inside the outline", which is the
    multi-part sheet mismatch already known from the rosettes -- the five "holes"
    are the other five parts. No defect there, and worth knowing: that check does
    not apply to any sheet carrying more than one part, which is about half of
    what this repository ships.
    A COUNT THAT MOVED. fold2's CLAUDE.md said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
2026-09-10 The port is a 7 x 14mm slot: same open area, and it clears
    Chosen because the clearance a port must keep is measured ACROSS the run and
    nothing else -- the tab slots line both walls the whole length, so a bore-square
    10 x 10 passes within 0.16mm of one wherever it is put. Length ALONG the run
    costs no clearance at all, so it is free, and it buys back what narrowing takes:
    across along clearance opening
    10 10 0.16mm 100mm2 uncuttable, and shipped for weeks
    7 7 1.66mm 49mm2
    7 14 1.66mm 98mm2 this
    6.6 20 1.86mm 132mm2
    98mm2 against the bore's own 100, so the air sees no restriction worth the n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
2026-09-10 The flat gate agrees the port is fixed, and wants one flag to say so
    Tenth pass, checking yesterday's port fix with the tool that found the fault
    rather than with the one that missed it.
    flat-part-check now reads 1.66mm where it read 0.03mm. That is the fix
    confirmed by something that does not share a line of code with it.
    It still FAILS, and should not, because the two gates disagree about the floor:
    ribbon_bore.py MIN_FEATURE 1.5mm
    check.py MIN_FEATURE 1.5mm
    flat-part-check edge distance 3.0mm
    The 3.0 is deliberate and right for what that tool was written for -- a
    bullroarer's cord hole, under string tension, which tears out. A cheek slot is
    not under tension. The flag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
2026-09-10 port_hole()'s docstring described geometry it no longer draws
    Thirteenth pass, on a lens the earlier ones did not use: which claims did my own
    changes falsify, in the files that make them?
    The port became a 7 x 14mm slot yesterday and three descriptions of it did not:
    PORT = False "a bore-square opening through the cheek"
    port_hole() "A square opening through the cheek at the mouth"
    "This cuts a bore-square hole in the last BORE of the run"
    The function's own docstring is the one that matters -- a reader who trusts it
    believes the port is 10 x 10 and cannot be told otherwise by the code, which now
    reads PORT_ACROSS and PORT_ALONG. All three corrected, and they no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
2026-09-10 The ribbon/ splice was still in this folder's documentation, all session
    Fifteenth pass. The first task of this session repaired eleven of these in
    ribbon_bore.py and ribbon_view.py, ran a detector over 476 text files, got
    "0 places where a directory name is glued to the token before it", and called
    the class clean. Nine of them were sitting in the CLAUDE.md beside those
    generators the whole time.
    A ribbon/Boxes.py tooth is -> A Boxes.py tooth is
    ...-ribbon/cheek-x2-cut-files.svg -> ...-cheek-x2-cut-files.svg
    ...-ribbon/panels-cut-files.svg -> ...-panels-cut-files.svg
    `ribbon/lasermade-tools/make-preview.py` -> `lasermade-tools/...`
    python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
2026-09-10 Three checks that would have passed over nothing
    checks() opens by saying that a check which measured nothing would print the
    same clean run as one that measured everything, so each reports its count.
    Three of them then compared a failure count to zero with nothing asserting
    there had been anything to count: the two slot checks and the wall-panel one.
    The kerf check was the visible one. With no pair to measure, `worst` stayed at
    infinity and the note passed reading "narrowest infmm drawn, infmm left after a
    0.13mm kerf" -- a sentence that cannot be true of any drawing.
    All fourteen shape-and-port runs still report 12 of 12.
    Claude-Sess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
2026-09-10 Three places that answered without saying they had not looked
    svgpath.py STEPPED SILENTLY PAST WHAT IT COULD NOT READ. The fall-through was
    `i += 1`, so a relative lineto, an arc, or a number the pattern did not match
    was skipped and the function returned a SHORTER point list than the path
    actually visits. Every measurement downstream is taken from that list -- the
    sliver check, the bed check, the overlap check, the label placement -- and a
    quietly truncated outline is the one input none of them survives and none of
    them reports. It also matched `-?\d+\.?\d*`, so `.5` was not a number to it,
    and it tokenised only the commands it handled, so any other command's
    coordinates arrived as bare num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
2026-09-11 The viewer's default put the page one directory above where it belongs
    Every one of the seven ordinary shapes ships its page in <shape>/<stem>/, beside
    the sheets it describes. The default output was the root of swept-curve, which is
    where the traced and torus pages live and where no ordinary shape's page has ever
    been -- so a bare run dropped an unshipped duplicate at the root, one directory
    up from the real page and beside the one root page that is real. Found by running
    the file with no arguments, which is the only way anyone would meet it.
    It writes into the design directory now, and refuses when there is none rather
    than inventing one: ribbon_bore.py makes that directory when it writes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
2026-09-13 Five cheek and port options that existed only as Inkscape edits
    Each of these was done by hand on a shipped sheet, and each is now a flag, so
    the sheet can be redrawn when the kerf or the sheet thickness moves. Nothing
    about the default changes: all 30 shipped sheets still redraw identically and
    repro.py is unmoved at 64.
    --narrow puts the cheek's edge ON the mortice's outboard edge, so there is no
    web and the band is only as wide as the duct: 20mm becomes 15.81. It is NOT
    --web=0, which stops at the wall's true face and leaves an 0.095mm rib no laser
    can cut. It reads the same slot_half() the mortice does, so it tracks --kerf
    and --sheet instead of restating a number they set. It costs the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
2026-09-13 The ply is 3mm now, so every curve is redrawn narrow and the old sheets move aside
    SHEET goes 2.94 -> 3.0 on the author's instruction, for stock that measures it.
    SHEET is the MATERIAL and belongs only in the depth of the hole it passes
    through, so this deepens every mortice by 0.06 and changes nothing else. THICK
    stays 3.0 and still carries every drawn dimension.
    It also makes every sheet cut before today stale -- a 3.0mm tab will not enter a
    slot cut for 2.94 -- so all 40 of them move to an old/ beside the sheets that
    replace them, and 42 new ones are drawn at 3mm ply and a 0.15mm kerf: every
    design under swept-curve, narrow, with a square port wherever the shape takes
    one. Seven do. The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
2026-09-13 The same 3mm ply and 0.15 kerf everywhere else, and the page route that never worked
    bore_split.py gets SHEET 2.94 -> 3.0 and KERF 0.13 -> 0.15, the two numbers
    ribbon_bore.py took on 2026-09-13. It was the only other generator with either:
    the bell and the mouthpiece are already 3mm ply and carry no kerf compensation
    at all, deliberately, because their rings are glued laminations.
    THICKNESS stays 3.0 and still dimensions the lattice. SHEET reaches only the slot
    Boxes cuts for a sheet to pass through, so this moves no airway and shortens the
    three wall runs that carry a thickness by 0.06mm each. KERF here is the FULL
    width and BURN is the radius Boxes wants; the paragraph above the constant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
2026-09-13 Forty previews rendered sheets that had been superseded, and the adapter was claimed by nothing
    Three things this tree asserted about itself were no longer true after the
    narrow regeneration, and all-gates.sh found each of them.
    previews/ held forty renderings of the full-width sheets and none of the
    forty-two narrow ones that replaced them -- so every picture in the folder
    showed a sheet nobody is cutting, and the gate read "40 of 43 stale". The
    forty move to previews/old/, mirroring each design's cut-files/old/, for the
    reason the sheets themselves were kept: a preview is the only readable picture
    of what a superseded sheet cut. Out of previews/ rather than deleted, because
    the gate walks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
2026-09-13 Every old/ leaves the repository and stays on the disk
    The twenty-one cut-files/old/ folders, and the previews/old/ that mirrors them,
    hold sheets a later regeneration replaced: a different ply, a different kerf, a
    full-width cheek where the design is now narrow. They were set aside rather
    than deleted so that what a particular run drew stays recoverable. They are a
    local archive, not part of what this repository ships, and they now say so --
    "old/" in .gitignore, and 169 files out of the index.
    The files are untouched on disk. git rm --cached removed them from tracking
    only, and history up to this commit still carries every one of them.
    Three passages had to change, because each asserted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
2026-09-13 Five claims the docs made that measurement no longer supported
    A thirteen-lens review of the ten markdown documents. The mechanical half was
    clean -- 10 of 10 documents, 363 SVGs, no stroke conflicts -- so everything
    below came from the judgment lenses.
    **The bed paragraph in greek-key was stale in four numbers and wrong in one
    claim.** Every figure recomputed from the sheets' declared sizes: 592.0 x
    284.4mm and 1684cm2, not 592.4 x 284.6 and 1686; telescope-wide is 598.9 not
    599.2, hilbert/open 598.6 not 598.8, margins 1.1 and 1.4 rather than 0.8 and
    1.2. "Half again the next one" was 1.5x when written and is 1.134x now, because
    the narrow serpentine cheek is 1485cm2.
    The substantive part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
2026-09-14 ribbon_view: drop the ply cheek plates, draw the airway alone
    The two slabs at full band width, 3mm proud of the passage top and
    bottom, meant every look at the inside was a look through plywood --
    which is the one thing this page exists not to do. Faces 6 and 7,
    'ply, top' and 'ply, bottom', are gone; six faces now, not eight.
    What they were there for -- 20mm of band around a 10mm passage -- the
    numbers panel says in words and the cut files show to scale.
    All eleven pages redrawn. The airway geometry is byte-identical to
    what shipped: only the ply vertices and quads are dropped.
    --trace was missing from the `known` flag set, so the guard that
    refuses an unknown flag refused the one flag w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
2026-09-14 The first swept curve off the laser is a spiral's pair of cheeks
    Author-supplied photograph of the 1000mm spiral's cheek sheet as cut, filed
    beside the cut-files/ folder that drew it, and named for the sheet it is:
    ported-square, narrow, cheek-x2. Two copies are in the picture because that
    sheet says CUT THIS SHEET TWICE -- the two cheeks are the same part and both go
    on the same way up -- and the second is visible under the first at the straight
    tail. Same original-plus-_web pair as the bell and the mouthpiece, 3000px and
    1400px, 1.9MB for the two.
    Which sheet it is was not taken on trust. The photograph was matched against
    every cut file in that folder rendered in a browser: the square po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
2026-09-14 Boxes.py draws every finger joint here and was nowhere credited
    Seven documents name Boxes.py or SnakeBox and not one of them said whose it is,
    where it comes from or what it is licensed under. The only place in the
    repository carrying a source for it was a comment in .doc-audit-ignore, which is
    config and not a document, and the URL there -- festi.info/boxes.py -- is not one
    the project itself gives.
    The facts come off the installed checkout rather than from memory: pyproject.toml
    in ~/Software/boxes gives boxes 1.2, maintainer Florian Festi
    <florian@festi.info>, Repository https://github.com/florianfesti/boxes, license
    GPL-3.0-or-later. That URL is what every credit below names, and doc-a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
2026-09-14 The spiral is glued up, and a glue-up this size is not airtight
    Both sheets are cut and the bore is assembled, with a mouthpiece on the
    straight tail and a bell on the port. The photograph shows what the cut
    files cannot: air gaps all along both rims, at every mitre and every tab.
    They are closed with shellac, which is why the three-turn coil at the top
    of the page is the colour it is and this spiral is still bare ply.
    Claude-Session: https://claude.ai/code/session_01XTXnWTXE6TaLYt3VGZwCm7
2026-09-14 The glued-up photograph is named for the sheets it is a photograph of
    It was filed as -1000mm-glued-up, dropping the -ported-square-narrow-cheek-x2
    that its as-cut sibling carries, so the pair no longer sorted or read as one
    design photographed twice.
    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
2026-09-14 The glued-up photograph is cropped to the instrument, and the spiral is in the index
    Two thirds of the frame was floor, so the coil rendered small in a column
    sized for it. Recropped from the original to 6830 x 6128 and rebuilt at the
    repository's two sizes.
    The spiral had no row in "A page for each" despite being the second design
    here that has been cut. It gets one, pointing at its viewer, and the
    paragraph above the table says why that row is unlike the four over it.
    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
2026-09-14 The spiral bore is a page, not four paragraphs inside somebody else's section
    It is the second design here that exists in wood, and it was being described
    between the swept-curve overview and the double spiral, where it could carry
    two photographs and no numbers. ribbon-spiral/ is its own page in the shape
    the other five have: what the cheek is, what the glue-up is not, a numbers
    table off the generator's own report, and the three shipped variants set
    against each other.
    The panel count in the moved prose said 38. The photographed sheet is the
    square-ported one, and --port-square folds each wall's 20mm lead panel into
    the facet it already lies on to clear room for the port, so it is 36. Bot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
2026-09-14 A duct has two ends, and only one of them could take a port
    port_hole() drew at cline[0] and nowhere else, so "a square port on the far
    end" was not a flag that was missing -- it was a shape the generator could not
    express. --port-both adds it, and the work was not the hole.
    A square port is bought by folding the mouth lead into the facet it is already
    collinear with, because the lead's one tooth sits exactly where the port wants
    to be. The far end needs the same purchase and merge_lead() only ever folded
    ps[0]. Without the tail fold the second port lands on the tail lead's only
    tooth and teeth_kept() refuses, naming the panel -- which is the right answer
    to the wrong question. So the flag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
2026-09-14 The trim gets to 956mm and the lead lands it on 1000
    The double spiral shortens by whole facets and nothing else, so it cannot reach
    a round number: nine facets an arm give 956.0mm and ten give 1058.2, about
    100mm a step. The last 44mm comes off the leads instead, 20mm to 42 at each
    end. A lead is a straight run tangent to the arm -- centreline() makes it by
    extending the end segment's own direction -- so it buys length without moving a
    facet of the coil, and the cost is 42mm of straight tail at each rim rather
    than a redrawn spiral. 1000.0mm exactly.
    THE 956mm SHEETS ARE REPLACED, NOT KEPT BESIDE IT. They were never cut, they
    lived for one commit, and two double spirals differing by 44mm w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
2026-09-15 The mouthpiece enters one face and the bell leaves the other
    A port through both cheeks is a socket right through, because the cheek is one
    part cut twice -- and the side you are not using is an open hole to plug. Two
    ports make four of those and two are waste. --port-per-cheek splits them
    instead: cheek-a carries the mouth port, cheek-b the far one, each sheet cut
    once. No geometry moves. Same coil, same sixty panels, the same two holes in
    the same two places; only which sheet each hole is drawn on.
    THE CONSEQUENCE IS THE INSTRUMENT, and it is worth saying plainly. The two
    openings are no longer in the plane of the coil: you blow into one face and the
    sound leaves the other, at points 222.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
2026-09-15 The coupon and the coiled trumpet are deleted
    TWO COUPONS, and both go. The swept curve's was --shape=coupon, the 180 degree
    R30 test piece: its folder, four sheets, four previews, its page, the shape in
    ribbon_bore.py and ribbon_view.py, and its two rows in the reproduce gate.
    tools/coupon-16mm/ was the other, four sheets that would have settled whether
    the play requirement is absolute or a fraction of the tab.
    THE COUPON WAS NOT AN IF, IT WAS THE FALL-THROUGH. centreline() ended with the
    180 degree arc and no test on the shape, so anything reaching the bottom of the
    chain was drawn as a coupon -- a misspelt --shape produced a test piece rather
    than a complaint. That end is now a refusal n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
2026-09-15 Ten of the twelve design pages were a viewer revision behind
    Regenerated, all twelve. When ribbon_view.py learned about ports I rebuilt the
    two pages I had touched and left the rest, and nothing in the repository could
    say so: the only page under a gate is the embed in the other repository.
    TWO WERE NOT MERELY BEHIND. The 1506mm double spiral's page opened its vertex
    list at [37.979, 115.117] where the generator draws [40.856, -111.865], and the
    halftest's was wrong the same way -- geometry that matches no flags its folder
    name claims. A page that draws a bore nobody drew is precisely what this file
    exists to prevent; it was doing the opposite, quietly, on the design this repo
    is named for.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
2026-09-15 An instrument is a bore and its two ends, so built/ is not inside parts/bore
    `parts/bore/built/` filed the three-turn coil as a kind of bore. It is not: it
    is the only thing in this repository somebody can pick up and blow, and what
    makes it that is the bell and the mouthpiece on it, neither of which is a bore
    and neither of which lived in that folder. The name promised an instrument and
    the path delivered a tube.
    built/coil-fold2-long-straight-3t/ the three-turn trumpet
    built/ribbon-spiral-bore10-45deg-R35to113/ the spiral
    THE SPIRAL CAME WITH IT, which is the point of the move rather than a side
    effect. It has been cut, glued up and fitted with both ends since 2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
2026-09-15 Two gates already expected these five files, and a fresh clone had none of them
    The 1000mm double spiral's single-port arrangement -- two cut sheets, its viewer
    page and the two previews -- was written to the working disk and never added.
    Nothing said so, because everything that reads them reads the disk.
    BOTH GATES NAME THESE FILES BY PATH. all-gates.sh has
    rr $DS-1000mm/cut-files ... -ported-square-narrow ...
    vp $DS-1000mm/ribbon-...-1000mm-ported-square.html ...
    so the sheets are 2 of the 48 and the page is 1 of the 13. On this disk they
    passed; on a fresh clone they were missing files, and the gate that exists to
    catch exactly that could not see its own blind spot.
    Verified c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
2026-09-15 A port seats a bell in 3mm of ply, and nothing has seated a mouthpiece in one
    The port cuts through ONE cheek, so whatever goes into it meets 3mm of birch
    rather than the whole 16mm sandwich, and that is the first thing anyone asks
    about the joint. The section answers it with the two photographs: the R35to113
    spiral's bell stands in its square port, carried by a 10 x 10mm hole in one
    cheek, and it holds.
    WHAT IT DOES NOT SETTLE IS THE MOUTHPIECE. On both built instruments the
    mouthpiece is out on the lead, seated in the tube end where four walls grip the
    full depth. A bell sits where it is put; a mouthpiece takes lip pressure and
    whatever the player leans into it, and the 3mm has never seen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
2026-09-15 Two bores are in wood, and one of them plays; also the spiral has 19 facets
    Two corrections, both of them a document contradicting another document in this
    repository rather than anything on disk.
    THE ONE THAT EXISTS -> THE ONE THAT PLAYS. built/CLAUDE.md opens "One folder per
    instrument that has been cut, glued and assembled", and there are two folders in
    it. README.md says "the two instruments that exist in wood". Meanwhile
    three-turn/README.md opened "**The one that exists.** Every other bore here is a
    drawing", which the spiral -- cut, glued up, a bell in its port, photographed on
    its own page -- has not been true of since it was cut. The distinction the prose
    actually wants is narrower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
2026-09-16 Every torus jammed at its seam, and a ring has no end to put a port on
    turn_at() answered 0 at the first and last vertex -- "a free end turns
    through 0", which is right for a run and wrong for a ring, whose first
    and last vertex are one vertex that turns like any other. So the two
    panels either side of the seam kept the THICK/2*tan(phi/2) the trim
    exists to take off, and "no two wall panels share plan area" failed with
    exactly 2 jamming pairs, one per wall, on EVERY torus at every facet
    count and every radius. 0.37mm a panel at 13 facets, 0.62mm at 8 -- the
    1.24mm the trim's own comment quotes from the bench. It now wraps, as
    offset() already did at the seam mitre and for the same reason. No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
2026-09-16 The floor for a ported ring is the PORT, and it is R36 not R120
    The ceiling was written down and the floor was not, so a reader reaching
    for --port-at on a default ring got a refusal and no hint which dial
    moved it. It is arithmetic: a port needs PORT_FROM_TIP + PORT_ALONG/2 =
    17mm of the facet it is measured along, a ring's facet is 2*R*sin(pi/n),
    so R >= 17/(2 sin(pi/n)). R32.84 at n=12 and R35.52 at n=13 -- measured
    both ways, R32.8 and R35.5 refuse with 16.98 and 16.99mm of facet, R32.9
    and R36 pass all twelve.
    Coarsening --facet is not the alternative. At --facet=60 the ring clears
    the port and fails "the web outboard of a slot is cuttable" at 0.951mm
    against 1.5mm, at EVERY radius --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
2026-09-16 "At every radius" overstated it: above R150 the check never runs
    The --facet=60 note said the web check fails at 0.951mm at EVERY radius,
    and measured two of them. It is 0.951 at R30, R60 and R120 -- constant,
    as claimed -- but from R150 the bed refuses the cheek outright and the
    twelve checks are never reached at all. The conclusion is unchanged and
    in fact stronger: --facet=60 has no passing radius. Only the MODE of the
    refusal changes, and the sentence now says which is which.
    Worth its own paragraph because of how the upper end reads if you count
    one signal: --facet=60 --radius=300 prints zero FAIL lines, and zero
    FAIL lines there means zero checks ran, not that it passed. Every row in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
2026-09-16 The two bed limits, named where they are set
    The sheet-vs-part note asserted the distinction and cited nothing, which
    is the same standing as the claim it exists to correct. Both limits are
    now named with where they are set: 600 x 308 in the "every sheet fits
    the P2S bed" check, "w > BED_W or h > BED_H"; 580 x 288 in pack(),
    "use_w, use_h = BED_W - 2*margin, BED_H - 2*margin", which is the one a
    refusal quotes.
    And the reason they differ, which is the part worth having: pack() packs
    into the bed minus a margin all round, because filling to the edge gave
    "a sheet 600 x 307 on a 600 x 308 bed, which passes a fits-the-bed check
    and cannot be positioned on a real machine". Its docstring has sai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
2026-09-16 The two paths are the point, so K is a dial and not a warning
    Both notes described the ring's two parallel branches as a defect --
    "that is a ring resonator, not a trumpet bore", "the two wants are
    incompatible; pick one". The uneven paths are wanted here, so that text
    steered a reader away from the thing the flag exists to do.
    Reframed around the dial. Ports on facets 0 and K split an n-ring into K
    facets one way and n-K the other, so K runs 1 to n//2: most lopsided at
    1, nearest balanced at n//2. The 13 ring's whole range is now tabled at
    both ends of its radius band, with the path difference and the first
    destructive null it implies -- c/2d, plane wave, no end correction,
    marked indicati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
2026-09-16 A 13-facet ring, 800.0mm, ports on facets 0 and 6, one per cheek
    The first closed ring this tree keeps. R128.571738 gives a centreline of
    exactly 800.0mm, which is inside the n=13 band -- the bed allows 840mm
    at R135 -- so nothing had to be given up to fit it. --narrow, like every
    other sheet here. Fourteen checks, none failing. Three sheets: two
    cheeks cut once each, 296 x 289mm, and the panels at 572 x 289.
    The two air paths are 6 facets and 7, 369.2 and 430.8mm, and they are
    uneven on purpose: this is a ring resonator with two parallel branches
    and the port separation is its tuning dial. K=6 is the least uneven
    split a 13 ring has.
    SHIPPING IT FOUND TWO THINGS, both older than this ring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
2026-09-16 Square ports on a ring, and a closed serpentine to put them in too
    TWO DESIGNS, both 800.0mm of centreline, both closed, both --narrow.
    The 13-facet ring gains a square-port variant beside its 7 x 14 one.
    --port-square was refused on every ring, and the refusal came from
    merge_lead() being right about a question it should not have been asked:
    --port-square implied --merge-lead unconditionally, and a ring has no
    collinear neighbour to fold a lead into. But the merge exists for ONE
    reason -- a 20mm lead carries a single tooth dead centre, where the port
    wants to be -- and --port-at puts no port on a lead. On this ring the
    ported facets are 57.59mm and carry four teeth each, so teeth_kept()
    dr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
2026-09-16 A closed serpentine racetrack, 1600.0mm, unported
    --shape=racetrack. Half the loop is a 180 degree cap then LOBES
    alternating half-circles joined by straights; the alternation nets zero
    turning, so the half turns 180, two halves turn 360, and a half turn of
    the plane maps the figure onto itself. Same closure argument as the
    scallop, one order lower, and it shuts whatever the radii: measured
    5e-13mm.
    IT EXISTS BECAUSE THE SCALLOP CANNOT GET HERE. A scallop repeats one
    lobe about a centre, so its envelope is circular and the bed's 288mm of
    HEIGHT bounds it in both axes while 580mm of width goes unused -- the
    shipped 800mm scallop is within one part-millimetre of the limit, and
    900mm is alread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
2026-09-16 The spiral is finished
    The R35to113 spiral has had its shellac. The photograph goes in built/ beside
    the as-cut and glued-up ones, at the same two sizes (3000 and 1400px on the
    long side), and ribbon-spiral/ gets a Finished section under it. The lines
    that still called it bare ply -- the page, the root README, built/CLAUDE.md --
    now say shellacked. None of them claims it has been blown.
    Gates: doc-audit 19/0 at the root, 18/0 on ribbon-spiral.
2026-09-16 One reading of the design switches per family, and gate rows for what hid
    Walk tools
    - bore_split.take_design_switches() and reset_design(): every switch that
    changes the parts, read once. bore_split, check, regress and nest all use
    it. check.py gains --sheet, --kerf, --play, --notch, --tag; nest.py gains
    all of them and reads walk files.
    - nest.py: nesting the mouthed loop laid out 30 parts with no holes; now 2.
    The Deepnest export writes each part's holes inside it.
    - regress: "closed loop 52, flat, mouth past a plain cap" -- passes now,
    fails 2 checks against the generator before c4c3f54.
    Ribbon tools
    - ribbon_bore.read_flags(): one flag table (it was written out three times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
2026-09-16 The scallop scoops inward: two facets at R41, not one straight chord
    The 800mm scallop's R40 scoop was a single 36 degree facet. Arcs are
    inscribed, so a one-facet scoop between two bulges turns +18 where they
    turned -18, and the centreline ran straight through it: every vertex turned
    0 or -36, and the loop was a rounded decagon with no inward bend.
    Now: 36 degree facets, 5 lobes, a 144 degree bulge of R44.22136 against a
    72 degree scoop of R41 (two facets, a +36 degree turn at each lobe),
    800.0mm, square ports on facets 1 and 14 (13 and 17 facets apart). 18 and
    24 degree facets make panels too short for a square port; from R42 no
    facet takes one. 60 wall panels + 2 cheeks, cheeks 282 x 279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
2026-09-16 Ring cheeks are cut as two closed contours, not one path with a slit
    cheek() joins a ring's outer and inner offsets into one list, which is a
    correct polygon (the two steps across the band coincide and cancel) and a
    wrong cut: written as one path, the laser followed the step and slit the
    cheek across its band and through the airway at the seam. Every ring cheek
    carried it -- both torus variants, the scallop, the racetrack.
    - contours() splits the outline where it returns to its first point
    (within 1e-9: the scallop's seam has no mitre, so its ends agree only to
    rounding); the sheet writes each loop as its own closed path.
    - Rim distances in checks() use the real contour edges, not the s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
2026-09-17 A closed oval with flattened ends, as small as the checks allow
    --shape=oval: half a loop taken twice -- a flat across the long end, an
    end arc, a side arc, an end arc -- closing by 2-fold symmetry. No ports.
    Defaults are the shipped design, the smallest found that passes all 13
    checks with a flat at each end, two facets on every arc, and a long axis
    at least 1.4x the short: 30 degree facets, ends R28 turning 60, sides R95
    turning 60, 13mm flats. 338.7mm centreline, 159 x 123mm cheek, 28 panels.
    The limit is the shortest panel, 10.21mm against 10mm for a tooth.
2026-09-17 The oval's long sides get parallel straights in the middle
    --oval-side-flat splits the side arc in two with a straight between, so
    the two long sides carry segments parallel to each other and to the long
    axis; FACET must then divide half the side turn.
    Re-searched for the smallest with that added (flat at each end, two
    facets per end arc, long axis >= 1.4x short): 30 degree facets, ends R28
    turning 60, sides R72 turning 30 either side of a 12.5mm straight, 12.2mm
    flats. 314.4mm centreline, 148 x 116mm cheek, 32 panels, all 13 checks;
    the shortest panel is 10.09mm against 10. Replaces the 338.7mm oval.
2026-09-17 A stadium oval: tightest half-circles, then parallel straights
    --oval-end-deg=90 is now allowed: the end arcs make a whole half-circle,
    the side arc turns nothing, and --oval-side-flat is the whole side. Refused
    without a side straight (that is a circle).
    Shipped: 45 degree facets, four per half-circle at R21.8, the tightest
    radius every check passes (R21.7 leaves a 9.98mm panel); straights of
    43.6mm, the o's own diameter. 220.7mm centreline, 124 x 79mm cheek,
    20 panels, 13/13. The 314mm oval is unchanged byte for byte.
2026-09-17 Move the stadium oval out to lyre-harp
    ribbon-oval-bore10-45deg-R21.8-straight43.6-221mm now lives outside this
    repository as ~/LaserMadeMusic/GIT/lyre-harp/
    lyre-harp-bore10-45deg-R21.8-straight43.6-221mm-prototype, files renamed to
    match and byte-identical otherwise. Its previews are dropped with it. The
    generator still draws it from the same flags.
2026-09-17 lyre_harp.py: a closed duct whose width changes round the loop
    The lyre-harp frame from the approved drawing, 400mm long: two independent
    closed walls -- a stadium outside, and a string hole with a concentric arch,
    parallel sides and a bump between tangent corners. The duct is 30 x 30mm
    over the arch and down the sides and opens below the hole into the
    resonator, 202mm along the axis. 30mm deep, cheek to cheek, throughout.
    Reuses ribbon_bore's panels, mortices, labels, packer, sheet writer and
    ring contours; adds the two outlines and twelve checks, including the
    duct's narrowest width (30.0000mm) and no cut line through the air. The
    checks were shown to fail with the band 1mm thin and with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
2026-09-17 Lyre-harp: the 2-lead 7-bight knot as a sound hole in the front cheek
    Read from knotwork-soundholes' cut file and placed unchanged, centred on
    the long axis 2/3 of the way up the resonator's air (135.8 of 203.7mm from
    the far end). Front cheek only, so the cheeks are now A (with the knot)
    and B (plain), each cut once. Knot waste cuts with the mortices, crossing
    marks engrave.
    New checks: the sound hole lies over the resonator (36.4mm clear of the
    nearest wall face) and sits where asked (against 2/3 written literally).
    Engraving within half a kerf of a hole's edge is not "in" the hole: the
    knot file ends two marks 0.0007 and 0.0018mm past a waste edge. Both new
    checks and the tolerance were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
2026-09-17 lyre_harp.py --drawing: the review drawing, drawn from the cut geometry
    Replaces the hand-scaled 831mm drawing with one read from build(): cheek
    rims as cut, the air's faces, the knot as placed, and dimensions measured
    off them -- 188 x 400, hole 116, 36mm walls-to-walls over the arch and
    sides, resonator 204, knot centre 135.8mm up (2/3). Upright by a quarter
    turn; a transpose mirrored the knot. Cut files unchanged byte for byte.
2026-09-17 Note that the lyre-harp sketch and the stadium prototype were deleted
2026-09-17 lyre_harp.py --render: the interactive 3D page, from the cut geometry
    Cheeks with the string hole and the knot, and all 49 panels at their own
    position, angle and length, drawn by three.js r128. The page approved as
    an artifact, now generated here and written beside the cut files in
    ~/LaserMadeMusic/GIT/lyre-harp/lyre-harp-bore30-188x400mm/.
2026-09-17 Lyre-harp: a laminated hitch-pin block inside the bottom end
    Six 3mm laminations, 18mm glued up, for hitch pins driven through the
    bottom wall. Each lies against the outer wall's inner face, 30mm wide from
    it, over 8 facets' length centred on the axis: 7 whole facets and a half at
    each end, since the bottom's odd facet count puts one facet on the axis.
    Its own sheet, numbered 1-6, drawn half a kerf oversize.
    Four checks, against 8 and 30 as asked: lies on the wall (1.4e-14mm),
    30.0000mm wide, clear of the sound hole (62mm), 18mm fits the 30mm duct.
    Shown to fail on 7 facets, 25mm wide, 11 layers and 2mm off the wall. The
    cheek and panel sheets are byte-identical to before. The drawing and 3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
2026-09-17 Lyre-harp: hitch-pin drilling marks on the front cheek
    7 pins, 2mm, 16mm apart across the long axis and centred on it, each on the
    hitch block's mid-line 15mm in from the bottom wall, so the row follows the
    curve. Engraved on cheek A as a 2mm circle with a cross, to drill through
    the cheek into the block. Two checks against 7 / 16 / 2 as asked: where the
    pins are, and that each lands in the block (14mm of wood round a pin).
    Shown to fail on 6 pins and 15mm spacing; 30mm spacing is refused as off
    the block. Drawing and 3D page show the pins.
2026-09-20 Lyre-harp: the tuning-pin block at the arch
    6 laminations, 18mm glued up, filling the duct at the arch: both edges are
    the walls' own faces, so it touches the outer wall and the string hole's
    wall with the duct's 30mm between them. It spans 120 degrees, ending at a
    facet midpoint 33.7mm past the outermost pin. Seven tuning pins on the
    band's mid-line, each in line across the instrument with its hitch pin,
    marked on cheek A as a cross -- no circle, since the pin's diameter is the
    builder's choice.
    Six checks: touches both walls (7e-15mm), 30.0000mm across, pins aligned
    within 1e-9mm, runs past the end pins, and the stack fits the duct.
    One lamination_sheet() now writes both blocks. Both span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
2026-09-20 Lyre-harp: cut at a 0.17mm kerf, its finger joints were loose
    The test piece came off the bed loose. lyre_harp.KERF sets ribbon_bore.BURN
    for its own run only: every trumpet design stays at 0.15, since those sheets
    are the record of parts already cut.
    Measured on the sheets: each mortice 2.850 x 5.900 becomes 2.830 x 5.880,
    each panel 63.538 x 36.150 becomes 63.558 x 36.170 -- 0.02mm off the hole
    and 0.02mm onto the tab, 0.04mm of interference a joint. All 25 checks
    pass; the drawing and 3D page are redrawn from the same run.
2026-09-20 Lyre-harp: --test writes an arch test piece, panels 4 to A
    Two cheek sectors and the 15 panels that stand between them: the string
    hole wall's 4-A and the 8 outer panels overlapping the same arc, 105
    degrees of it, with 10mm of rim past the outermost mortice. For trying the
    finger joints at the 0.17mm kerf before cutting a whole frame. It refuses
    to write if a mortice corner falls outside the sector.
    Outer panels are chosen by OVERLAP with the arc: by midpoint dropped the
    two at the ends, which share their joints with the inner run. They are
    also pinned to the arch side, since angles wrap at the resonator end and
    a panel down there read as an arch angle.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
2026-09-24 Rebuild with md2html's theme-button fix for narrow screens
    Below 900px the theme button no longer covers the contents list.
2026-10-09 swept-curve: CLAUDE.md down to the rules, the reasoning moved to NOTES.md
    CLAUDE.md was 1128 lines, loaded whole into every session working here.
    It is now 177: each rule in a line or two, with the NOTES.md heading that
    explains it in brackets. NOTES.md is the old file unchanged bar a title
    and two lines saying what it is, so nothing is lost; its history follows
    the rename. ribbon_view.py's one pointer into the old file now names
    NOTES.md.
2026-10-09 Fix fold2's regenerate path, drop stale counts, point swept-curve at the root README
    fold2: the regenerate and gate commands ran from tools/ with D=., so
    --write $D/bore would have written to tools/bore. D is now
    ../parts/bore/concept/walk/coil/fold2, the path regress.py's DESIGNS
    holds; gating the shipped sheets through it gives 196 checks, 0 failed.
    Design and check counts written into prose had drifted apart (25, 31
    and 33 designs; 195 and 196 checks on one bore). They now say "every
    design in DESIGNS" and "the check count the gate prints", which cannot
    go stale. The README's measured 33-design result is left as it is.
    swept-curve has no README of its own; its commands now regenerate an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
2026-10-09 CLAUDE.md: rebuild pages with rebuild-page.sh
    Six hand-written md2html + doc-audit pairs, each with its own relative
    path to lasermade-tools, become one call to rebuild-page.sh with the
    writeup's folder. parts/ had the same fault swept-curve had: it
    regenerated a README.md that folder does not have. It now rebuilds the
    two writeups it means, the root README and ../ends/. Every command was
    run from its own folder; every page comes back unchanged.
2026-10-12 swept-curve: shapes named double-spiral, ess, three-lobe serpentine, double volute
    Folders and files renamed: dspiral -> double-spiral, wave -> ess,
    opposed -> three-lobe-serpentine-with-collinear-ends, volute ->
    volute/double-volute and volute/single-volute. Removed: the 196mm and
    240mm halftests, the two-port 1000mm page, the 1506mm plain cheek,
    traces/volute.json, and the 20 previews left with no cut file.
    The --shape keywords follow the names, and ribbon_bore.py writes the
    new stems; the shipped sheets' <title>s and the pages' embedded shape
    were brought into line, and every sheet and page reproduces byte for
    byte. NOTES.md and CLAUDE.md say what is gone.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
2026-10-12 Every build is press-fit, not glued
    The three-turn trumpet, the 1000mm spiral and the greek spiral are all
    press-fit, with shellac filling the air gaps. Pages, notes and build
    steps that called them glued, or said the ends and ring stacks glue on,
    now say press-fit, seat or stack. The elbow notes keep "butt-glued":
    that is the reason a stranded turn is costly, not a claim about a build.
2026-10-12 Spiral photo renamed glued-up -> press-fit
    The 1000mm spiral is press-fit, so its photo's name says so. Both
    copies renamed; the spiral's page and the swept-curve notes follow.
2026-10-12 Fix the four review findings
    - ribbon-spiral: the "report only" command now passes --no-write
    (it wrote two SVGs beside the generator) and says it runs from the
    repository root, as its write command already did.
    - greek-spiral, three-turn: "the generator lives in ../tools" said
    the commands run from the page's folder; they run from the root.
    - bore_split.py: the cut-list heading no longer says "every part
    engraved" for a one-section bore, which engraves nothing.
    - coil search: plate areas written 2881mm², matching the root README,
    fixed in gen_readme.js and regenerated.
2026-10-12 Bell and mouthpiece are glued; hub embed retired
    Ring stacks cannot be press-fit, so the bell, the mouthpiece and each
    end's joint to the bore are glued; the bore stays press-fit. The
    swept-curve notes no longer describe a hub embed that is gone.
2026-10-13 Previews on a white ground (#ffffff), not cream
    Only the ground rect changed; make-preview.py now draws white.
2026-10-14 Viewers follow the site's theme button; the dark-only ones get a light palette
2026-10-14 The built spiral's page shows its bell and mouthpiece, as built
    ribbon_view.py --ends seats the bell over the port on the bottom cheek and the
    mouthpiece on the far end, both read from trumpet-elbows-allowed's part-view.py;
    a checkbox takes them off. The page now draws the cut variant, square port and
    cap. Every page is redrawn for the template, and the embed extract no longer
    splits at the theme script. The spiral has been blown; its note is not yet
    reported.
2026-10-14 With the bell in the port, draw the other cheek's hole plugged
2026-10-14 Drop the R36to144 and R74to144 spirals: the built spiral already has their shape
    Their cut files, previews and pages go; the README, the generated-folder list
    and a measurement note follow. Every page is redrawn for the template change
    the last commit made and left the others stale.
2026-10-15 Short double spiral's page: no port, mouthpiece and bell on the tube ends
    Drawn like the long one; renamed from -ported-square.html. Its ported sheets
    are still shipped.
2026-10-15 Viewer: draw each cheek as one part, not a plate per wall panel
    By face, a cheek quad's mitre edges take its fill colour and only its
    edges along the duct are outlined. All 12 design pages redrawn.
2026-10-19 Bed is 600 x 305mm, cut-tested; racetrack re-solved to fit
    The largest rectangle the xTool P2S cut, tested 2026-10-19, is 600 x 305mm,
    not the 600 x 308 assumed here until now. Usable height drops from 288 to 285, and the
    racetrack's 285.4mm cheek no longer fit. 31mm straights with R132.809 caps
    keep it at 1600mm and pass 13/13. Ring ceilings re-measured: R132 at n=12,
    R134 at n=13.
2026-10-22 Link back to all projects at the top of the README and the page
    The rest of the build files now points at lasermademusic.html, where the
    instruments moved when the root page became a directory.
2026-10-23 Open the page with the built spiral's --embed view
    The full viewer page, framed, showed its own header and control panel
    squeezed into the frame. ribbon_view.py's --embed build is the model alone,
    and the full page stays one link away.
2026-11-07 Call lasermade-tools' Rust programs, not its Python scripts
    The tools became Rust on 2026-11-07: target/release/<name> in lasermade-tools
    (cargo build --release there) replaces python3 <name>.py, in commands,
    manifests and prose. Pages rebuilt; no generated file changes otherwise.
2026-11-08 ribbon_bore, ribbon_view and volute in Rust; the Python goes
    The whole generator, the viewer (its page and embed kept as browser code in
    ribbon_view_page.rs, its --ends reading of the bell and mouthpiece in Rust)
    and the single volute's compass construction. Byte-identical on 123
    generator runs, 31 viewer runs, 11 volute runs and every shipped sheet and
    page. sheet() splits into items_for() and sheet_items(), so lyre-harp can cut
    its one cheek as two. Commands in README, CLAUDE.md and NOTES name
    target/release.
2026-11-08 Each design as a parametric SolidCraft design, with its STEP
    ribbon_solidcraft.rs (ribbon_view --solidcraft=FILE, the page's flags plus
    --narrow) writes the bore with its centreline vertices, bore, ply and the
    cheek's slot numbers as parameters, and every wall, rim and panel worked out
    from them as ribbon_bore works it out, checked against the generator's own
    before it is written. Eleven designs, each with solidcraft/NAME.sc, its script,
    and step/NAME.step; no part overlaps another, and bore 12 matches --bore=12.
2026-11-09 SolidCraft designs: finger joints, mortices, ports; they read back
    Every panel has its teeth (as many as its length holds, a floor()
    parameter and a patterned sketch; twelve ported-design panels keep the
    generator's count) and both cheeks their mortices. The rims are as cut,
    half a kerf inside the drawn line, free ends included, so each mortice
    is an open notch. The 1506 mm double spiral, the scallop and the torus
    are built with the ports their committed cheeks are cut with, as the
    spiral already was, each port checked against the generator.
    sc-flatten --redraw-all now lands every one of the eleven designs on
    its committed cut files: cuts within 0.021 mm, marks within 0.113 mm.
    Co-Authored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
